eSpark-Backup/junaidalam-audioswitch/Design-Files/Audio-Switch-v2.0/Deliverables/Renderings/2D_C_View.PNG

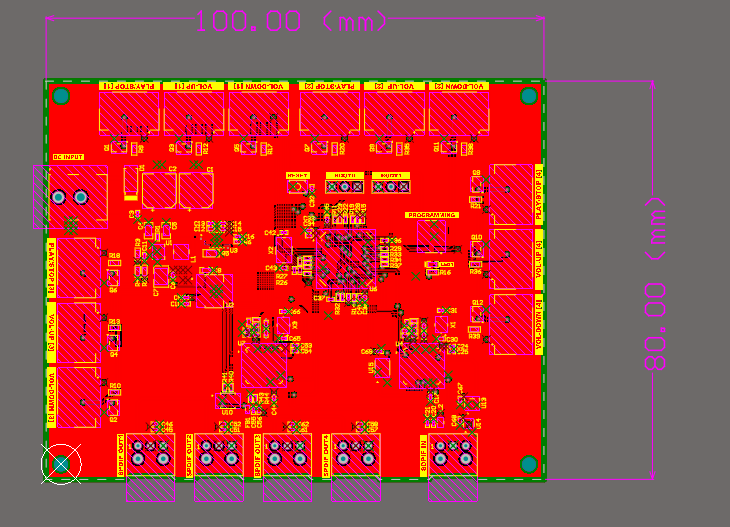
Design-Files/Audio-Switch-v2.0/Deliverables/Renderings/2D_C_View.PNG
