eSpark-Backup/junaidalam-audioswitch/Design-Files/Audio-Switch-v2.0/Deliverables/Renderings/Isometric_View.PNG

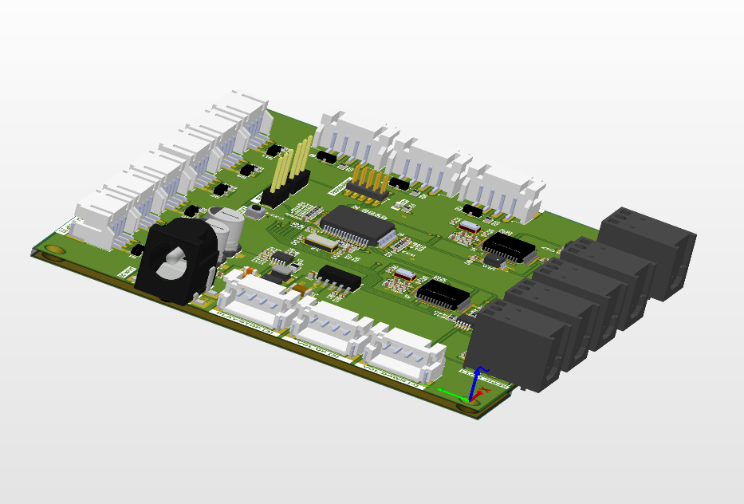
Design-Files/Audio-Switch-v2.0/Deliverables/Renderings/Isometric_View.PNG
