eSpark-Backup/junaidalam-audioswitch/Design-Files/Audio-Switch-v2.0/Deliverables/BOM/BOM of Audio-Switch-v1.0.xlsx

# | Item Type | Designator | Description | Manufacturer Part Number | Manufacturer | Comment | Quantity
1 | Capacitor | C1, C2 | CAP ALUM POLY 47UF 20% 25V SMD | 25SVPF47M | Panasonic | 47uF | 2
2 | Capacitor | C3, C11, C17, C19, C21, C23, C25, C27, C32, C34, C35, C36, C37, C38, C40, C44, C45, C48, C50, C51, C54, C55, C57, C60, C61, C67, C68, C69 | CAP CER 0.1UF 25V X7R 0402 | CC0402KRX7R8BB104 | Yageo | 0.1uF | 28
3 | Capacitor | C4, C5 | CAP CER 22UF 25V X5R 0805 | CL21A226MAYNNNE | Samsung | 22uF | 2
4 | Capacitor | C6, C18, C20, C22, C24, C26, C46, C47, C49, C52, C53, C56, C58, C59, C62 | CAP CER 10UF 10V X5R 0402 | CL05A106MP5NUNC | Samsung | 10uF | 15
5 | Capacitor | C7 | CAP CER 47uF 25V 1210 | TMK325ABJ476MM-P | Taiyo Yuden | 47uF | 1
6 | Capacitor | C8 | CAP CER 2.2UF 25V X5R 0603 | CC0603KRX5R8BB225 | Yageo | 2.2uF | 1
7 | Capacitor | C9, C33, C39 | CAP CER 1UF 16V X5R 0402 | CC0402KRX5R7BB105 | Yageo | 1uF | 3
8 | Capacitor | C10 | CAP CER 10000PF 25V X7R 0402 | CC0402KRX7R8BB103 | Yageo | 10nF | 1
9 | Capacitor | C12, C13, C14, C15, C16, C41 | CAP CER 4.7UF 16V X5R 0402 | CL05A475MO5NUNC | Samsung | 4.7uF | 6
10 | Capacitor | C28, C63 | CAP CER 0.068UF 50V X7R 0402 | CC0402KRX7R9BB683 | Yageo | 68nF | 2
11 | Capacitor | C29, C64 | CAP CER 4700PF 50V X7R 0402 | CC0402KRX7R9BB472 | Yageo | 4.7nF | 2
12 | Capacitor | C30, C31, C65, C66 | CAP CER 18PF 50V C0G/NP0 0402 | GCM1555C1H180GA16D | Murata | 18pF | 4
13 | Capacitor | C42, C43 | CAP CER 30PF 50V C0G/NPO 0402 | CC0402JRNPO9BN300 | Yageo | 30pF | 2
14 | Schottky Diode | D1 | 60V 700mV@1A 1A SMA(DO-214AC) Schottky Barrier Diodes (SBD) ROHS | SS16 | MDD | SS16 | 1
15 | Ferrite Bead | FB1 | FERRITE BEAD 120 OHM 0603 1LN | BLM18SG121TN1D | Murata | BLM18SG121TN1D | 1
16 | Connectors | J1 | DC Power Receptacle Jack 2.5A 2.5mm 6.5mm SMD Power Connectors RoHS | DC-005-5A-2.5-SMT | XKB Enterprise | DC-005-5A-2.5-SMT | 1
17 | Connectors | J2, J3, J5, J6, J8, J9, J11, J12, J13, J14, J15, J16 | CONN HEADER SMD R/A 4POS 2MM | S4B-PH-SM4-TB(LF)(SN) | JST | S4B-PH-SM4-TB(LF)(SN) | 12
18 | Male Header | J4, J7 | Gold 250V 3A Straight Square Pins 2.5mm 3P 260℃ 6mm -40℃~+105℃ 3mm 2.54mm Plugin Black Brass 1x3P Plugin,P=2.54mm Pin Headers ROHS | X6511WV-03H-C60D30 | XKB | X6511WV-03H-C60D30 | 2
19 | Jtag Male Header | J10 | CONN HEADER SMD 10POS 1.27MM | 20021121-00010C4LF | Amphenol FCI | 20021121-00010C4LF | 1
20 | Inductor | L1 | 2.34A 1.5uH Shielded Power Inductors ±20% SMD Power Inductors ROHS | LVT303012-1R5M-N | Chilisin Elec | 1.5uH | 1
21 | Inductor | L2 | 280mA 47uH ±20% 3.4Ω 0805 Inductors (SMD) ROHS | MLW2012RF-470MT | MetalLions | 47uH | 1
22 | LED | LED1 | RED LED 0603 Light Emitting Diodes | NCD0603R3 | Foshan NationStar Optoelectronics | RED | 1
23 | BJTs | Q1, Q2, Q3, Q4, Q5, Q6, Q7, Q8, Q9, Q10, Q11, Q12 | TRANS PREBIAS NPN 50V SOT23-3 | DDTD113ZC-7-F | Diodes Zetex | DDTD113ZC-7-F | 12
24 | Resistor | R1, R8, R11, R14, R15, R19, R24, R25, R26, R27, R28, R29, R30, R31, R32, R33, R34, R37, R40, R41, R43 | RES 10K OHM 1% 1/16W 0402 | RC0402FR-0710KL | Yageo | 10K | 21
25 | Resistor | R2 | RES SMD 523K OHM 0.1% 1/10W 0603 | RT0603BRD07523KL | Yageo | 523K | 1
26 | Resistor | R3, R4 | RES SMD 100K OHM 0.1% 1/10W 0603 | RT0603BRD07100KL | Yageo | 100K | 2
27 | Resistor | R5 | RES SMD 649 OHM 0.1% 1/8W 0805 | RT0805BRD07649RL | Yageo | 649R | 1
28 | Resistor | R6 | RES 49.9K OHM 1% 1/16W 0402 | RC0402FR-0749K9L | Yageo | 49.9K | 1
29 | Resistor | R7, R42 | RES 680 OHM 1% 1/16W 0402 | RC0402FR-07680RL | Yageo | 680R | 2
30 | Resistor | R9, R10, R12, R13, R17, R18, R20, R21, R35, R36, R38, R39 | RES SMD 100 OHM 1% 1/10W 0603 | RC0603FR-07100RL | Yageo | 100R | 12
31 | Resistor | R16 | RES SMD 220 OHM 1% 1/10W 0603 | RC0603FR-07220RL | Yageo | 220R | 1
32 | Resistor | R22, R23 | RES 4.7K OHM 1% 1/16W 0402 | RC0402FR-074K7L | Yageo | 4.7K | 2
33 | Resistor | R44 | RES 33 OHM 1% 1/16W 0402 | RC0402FR-0733RL | Yageo | 33R | 1
34 | Switch | SW1 | SWITCH TACTILE SPST-NO 0.05A 12V | B3U-1000P | Omron | B3U-1000P | 1
35 | IC | U1 | IC REG BCK BST ADJ 3.6A 15VQFN | TPS63070RNMR | Texas Instruments | TPS63070RNMR | 1
36 | IC | U2 | IC REG LINEAR 3.3V 1A SOT223-6 | TPS79633DCQR | Texas Instruments | TPS79633DCQR | 1
37 | IC | U3 | IC REG LIN POS ADJ 200MA 10MSOP | LT3042IMSE#PBF | Analog Devices / Linear Technology | LT3042IMSE#PBF | 1
38 | Amplifiers - Audio | U4, U7 | IC AUDIO TRANSCEIVER 48LQFP | PCM9211PTR | Texas Instruments | PCM9211PTR | 2
39 | FIBER OPTIC RECEIVER | U5 | FIBER OPTIC RECEIVER IR | PLR237/T10BK | Everlight | PLR237/T10BK | 1
40 | Microcontrollers | U6 | IC MCU 32BIT 256KB FLASH 64LQFP | STM32F401RCT6 | STMicroelectronics | STM32F401RCT6 | 1
41 | IC | U8, U9, U11, U12 | TRANSMITTER FBR OPT IR PHOTOLINK | PLT133/T10W | Everlight | PLT133/T10W | 4
42 | IC | U10 | IC SWITCH SP4T X 1 5OHM 10VSSOP | TMUX1204DGSR | Texas Instruments | TMUX1204DGSR | 1
43 | Buffers, Drivers and Transceivers | U13 | IC BUFF NON-INVERT 5.5V SOT23-5 | SN74LVC1G125DBVR | Texas Instruments | SN74LVC1G125DBVR | 1
44 | Logic Gates | U14 | IC GATE AND 1CH 2-INP SC70-5 | SN74LVC1G08DCKR | Texas Instruments | SN74LVC1G08DCKR | 1
45 | IC | U15 | IC BUFFER NON-INVERT 5.5V SM8 | SN74LVC2G125DCTR | Texas Instruments | SN74LVC2G125DCTR | 1
46 | Crystal | X1, X3 | 24.576MHz SMD Crystal Resonator 12pF 60Ω ±10ppm -40℃~+85℃ SMD3225-4P Crystals ROHS | S3224576121060 | JGHC | S3224576121060 | 2
47 | Crystal | X2 | 8MHz 18pF ±10ppm SMD5032-4P Crystals ROHS | 5TJ480000XYLBC | JYJE | 8MHz | 1
