eSpark-Backup/junaidalam-audioswitch/Design-Files/Audio-Switch-v2.0/Deliverables/Supporting_Files/Audio-Switch-v1.0.step

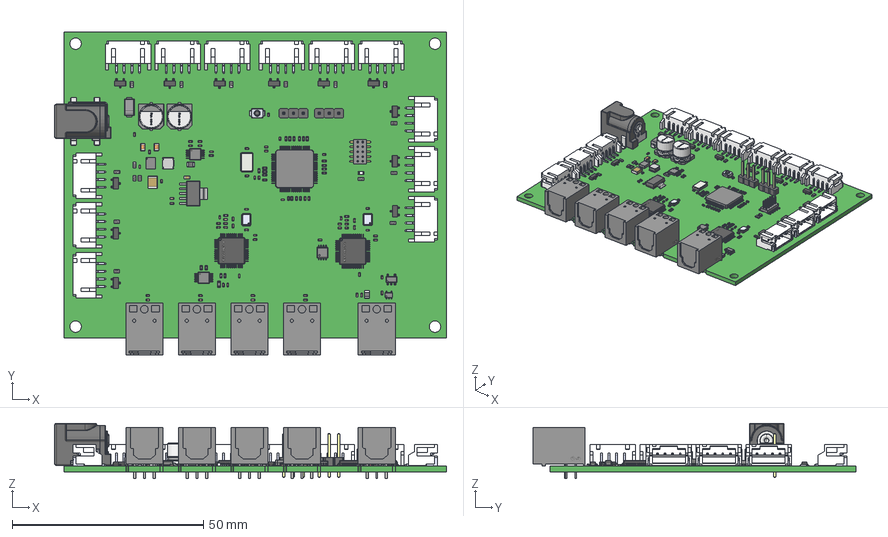
[picture p9: CAD file, 2024-05-20]
Design-Files/Audio-Switch-v2.0/Deliverables/Supporting_Files/Audio-Switch-v1.0.step
102.5 x 84.4 x 14.5 mm
SN74LVC2G125DCTR
SN74LVC1G08DCKR
SN74LV1T34DBVR
User Library-P-LQFP48-7x7-0_50 x 2
STM32F103RCT7
CircuitWorks-SOT-23 x 12
MetalFrame x 2
Pin1Marker x 2
Pin3 x 2
Pin1 x 2
Lid x 2
Pin4 x 2
Pin2 x 2
Ceramic x 2
User Library-CRYSTALSMD5X32
LTC2634HMSE-LMI10#PBF
User Library-SOT-223-6
TPS63070RNMR--3DModel-STEP-56544
User Library-OMRON B3U1000P
User Library-RES_1005-0402 x 27
User Library-RESC1608X05N x 16
User Library-CR2012-0805
User Library-LED SMD0603
SxB-PH-SM4-TB white_4 x 12
User Library-RM127_10pin_Header
User Library-Header_Male_3Pin_PinArray x 2
User Library-Header_Male_3Pin_BodyArray x 2
CUI-PJ-002A-SMT
Lötende x 2
base x 3
User Library-DO-214AC SMA
User Library-Capacitor 0402 x 63
User Library-CAPC1608X09
User Library-CAPC3225X10
User Library-0805 SMD Capacitor x 2
cap x 2
pins x 2
logo x 2
