eSpark-Backup/junaidalam-audioswitch/(list of files, cad)

Other CAD files:
Design-Files/Audio-Switch-v2.0/Deliverables/Supporting_Files/Audio-Switch-v1.0.DWG
Design-Files/Audio-Switch-v2.0/Deliverables/Supporting_Files/Audio-Switch-v1.0.DXF
