eSpark-Backup/junaidalam-audioswitch/Design-Files/Audio-Switch-v2.0/Schematic/Audio-Switch-v2.0.pdf

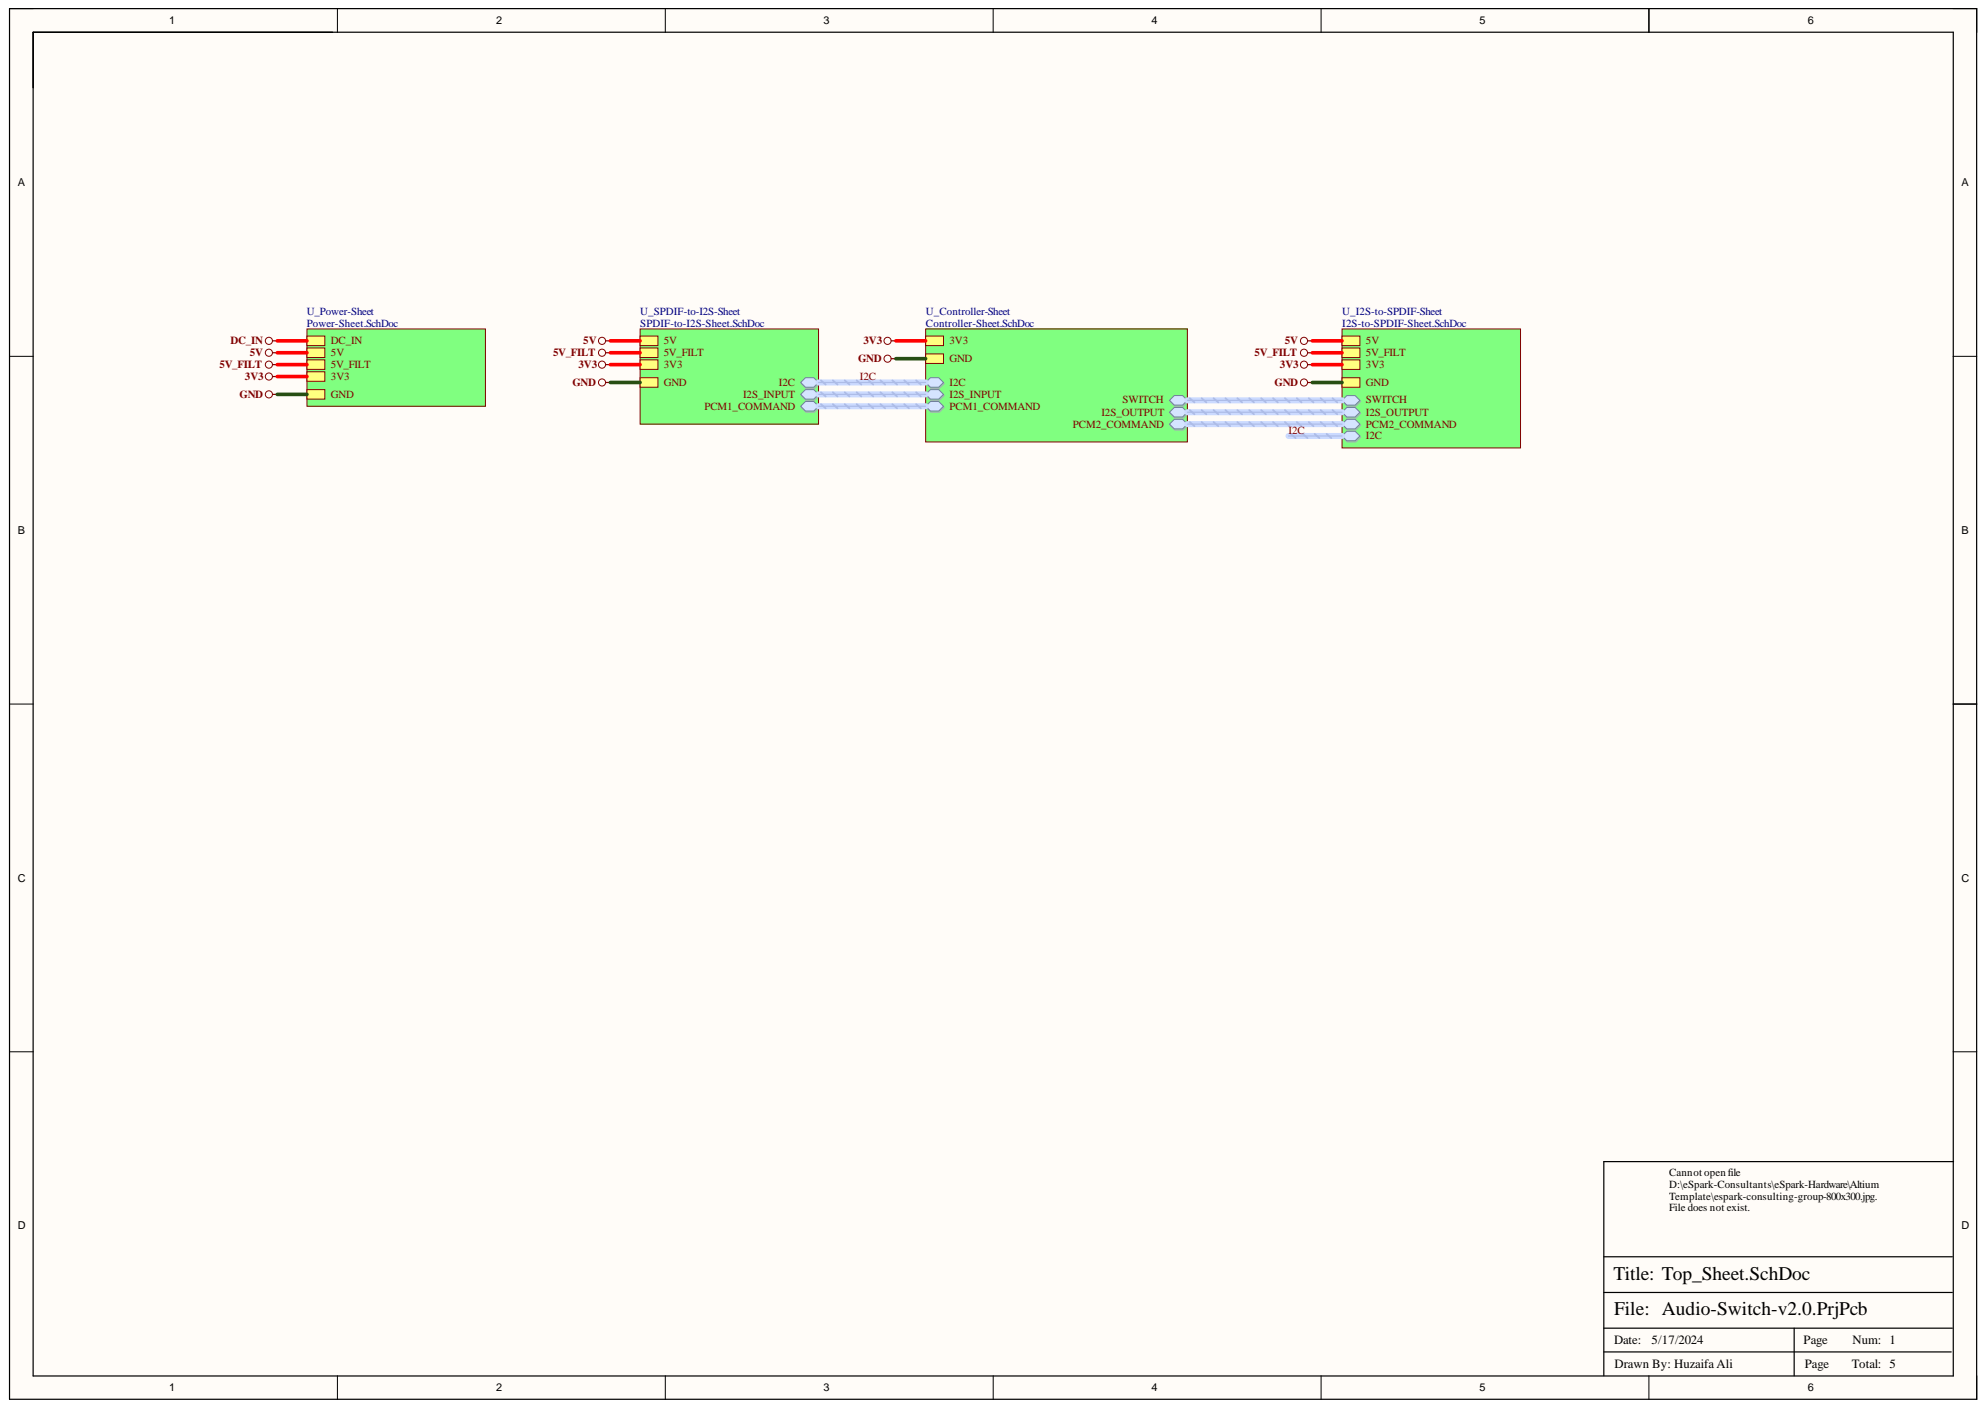
[picture p10: page 1]

Cannot open file
D:\eSpark-Consultants\eSpark-Hardware\Altium
Template\espark-consulting-group-800x300.jpg.
File does not exist.

Date: 5/17/2024 | Page Num: 1

Drawn By: Huzaifa Ali | Page Total:

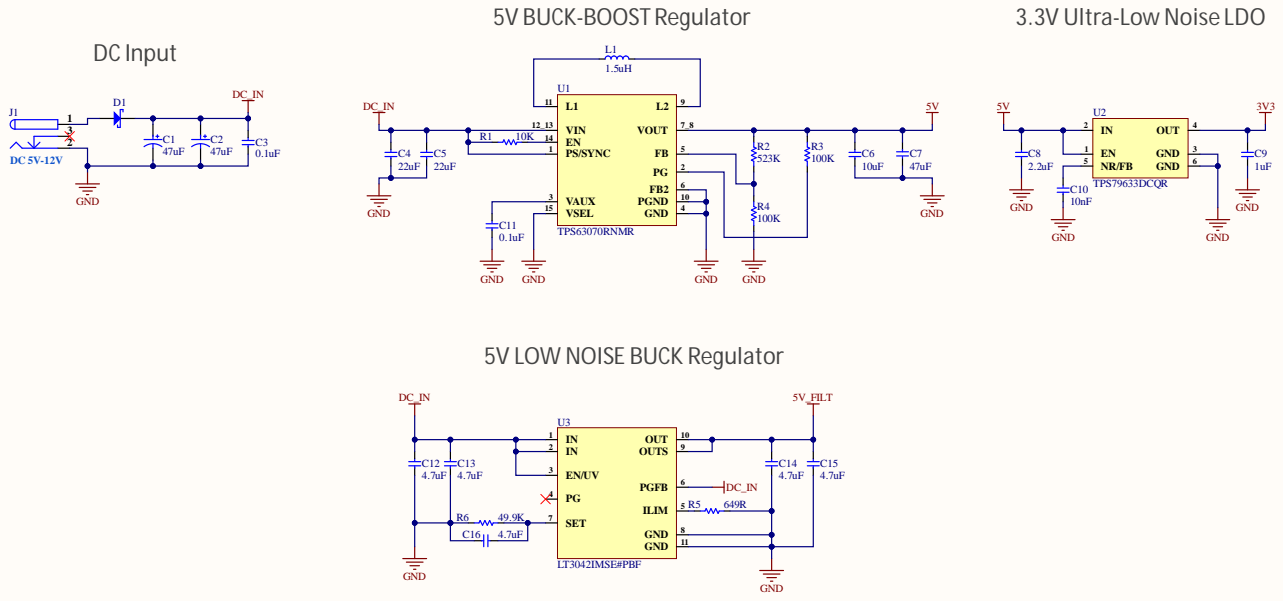
[picture p11: page 2]

5V LOW NOISE BUCK Regulator

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

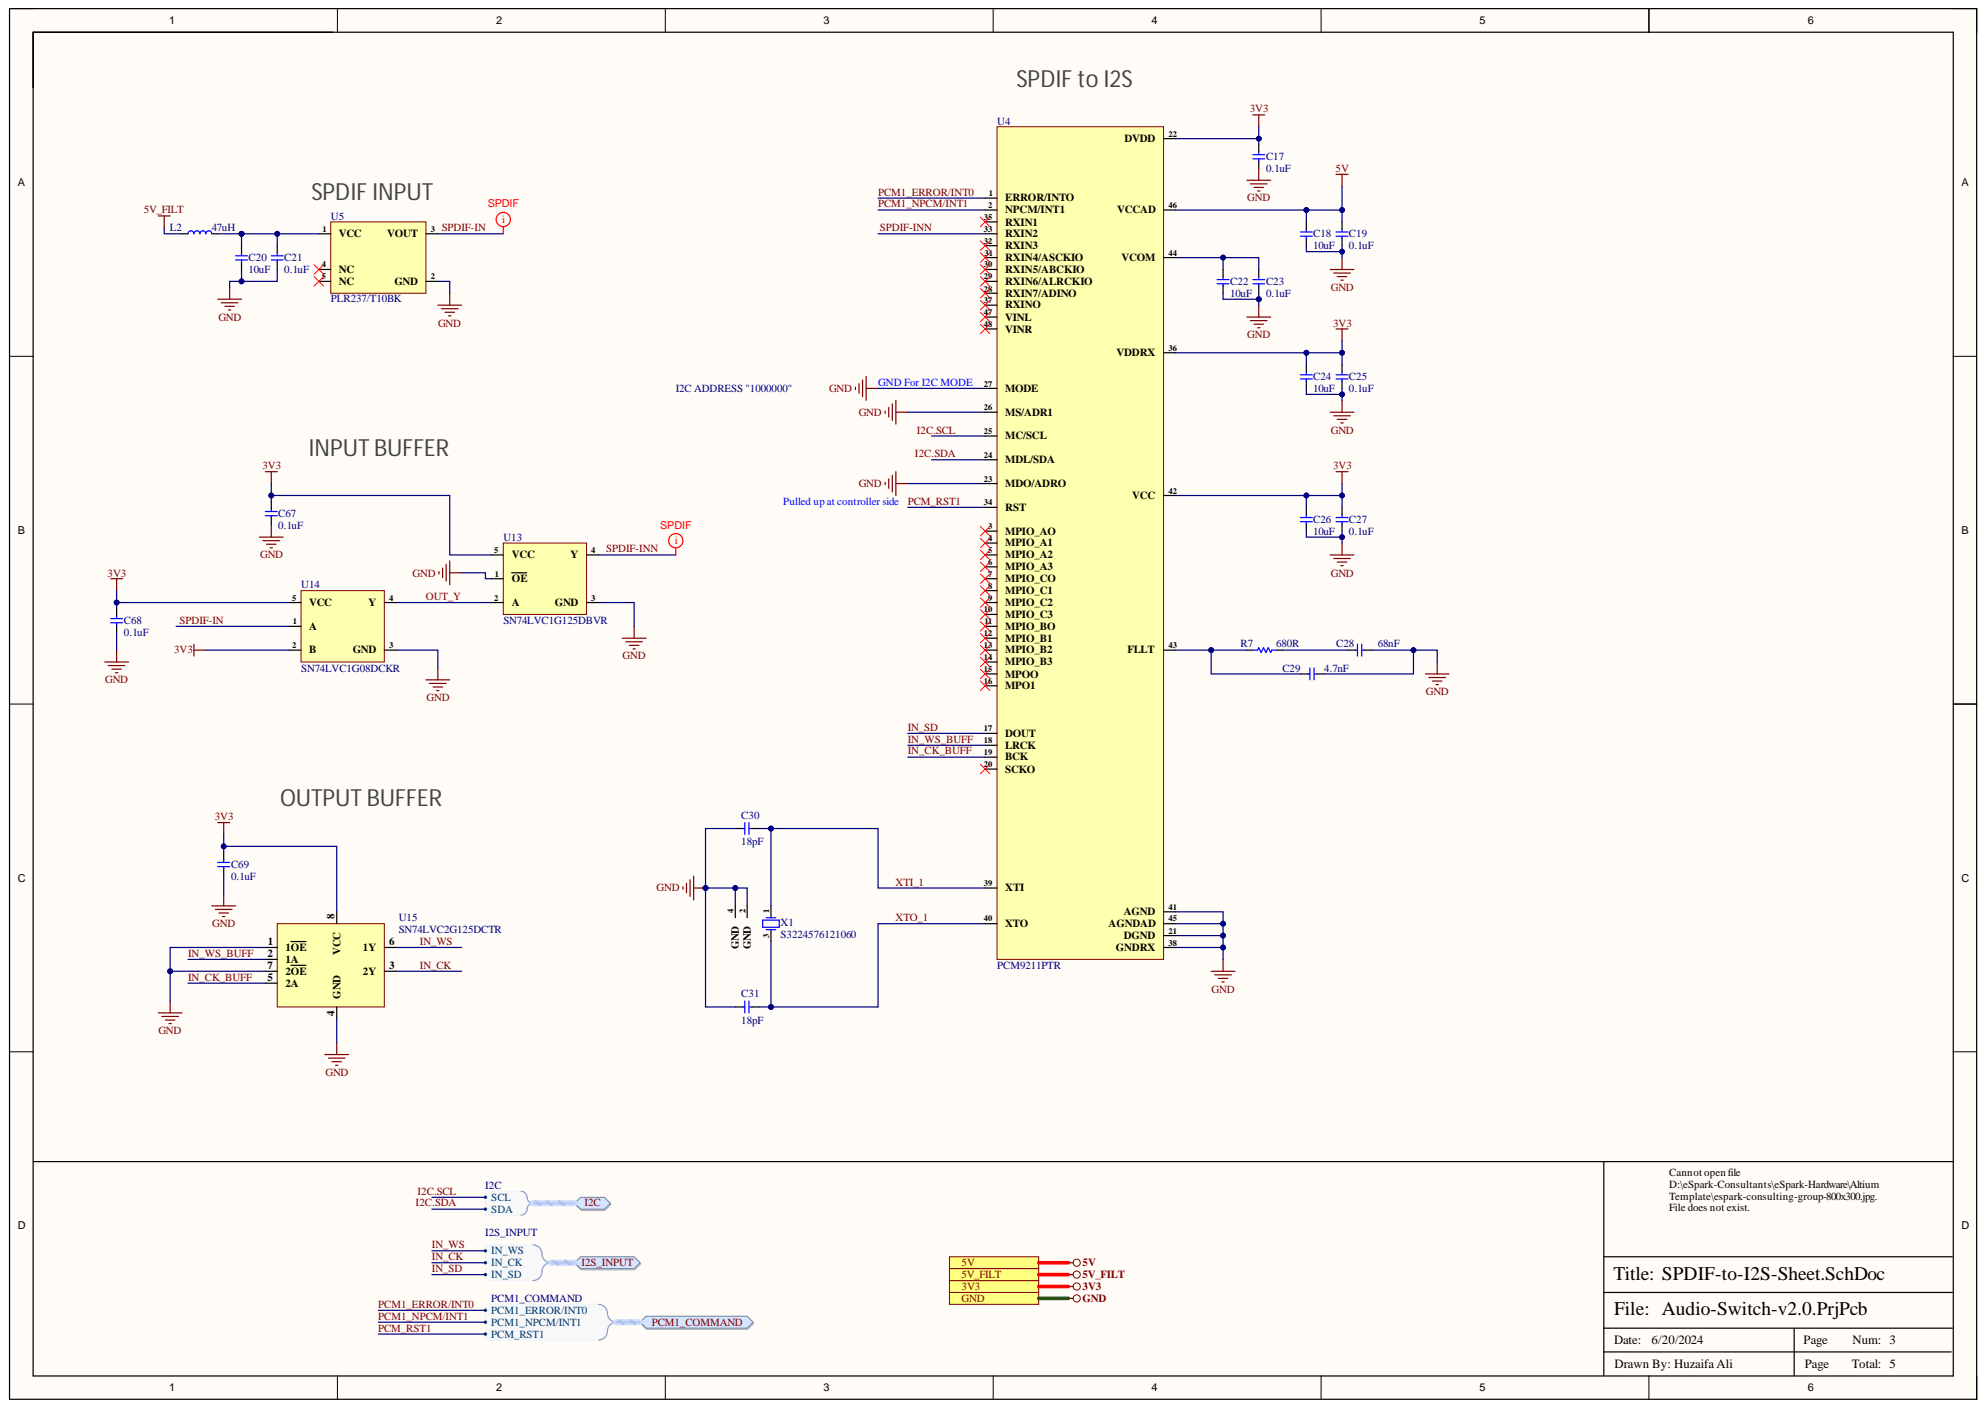
[picture p12: page 3]

Pulled up at controller side PCM_RST1

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

SPDIF-to-I2S-Sheet.SchDoc

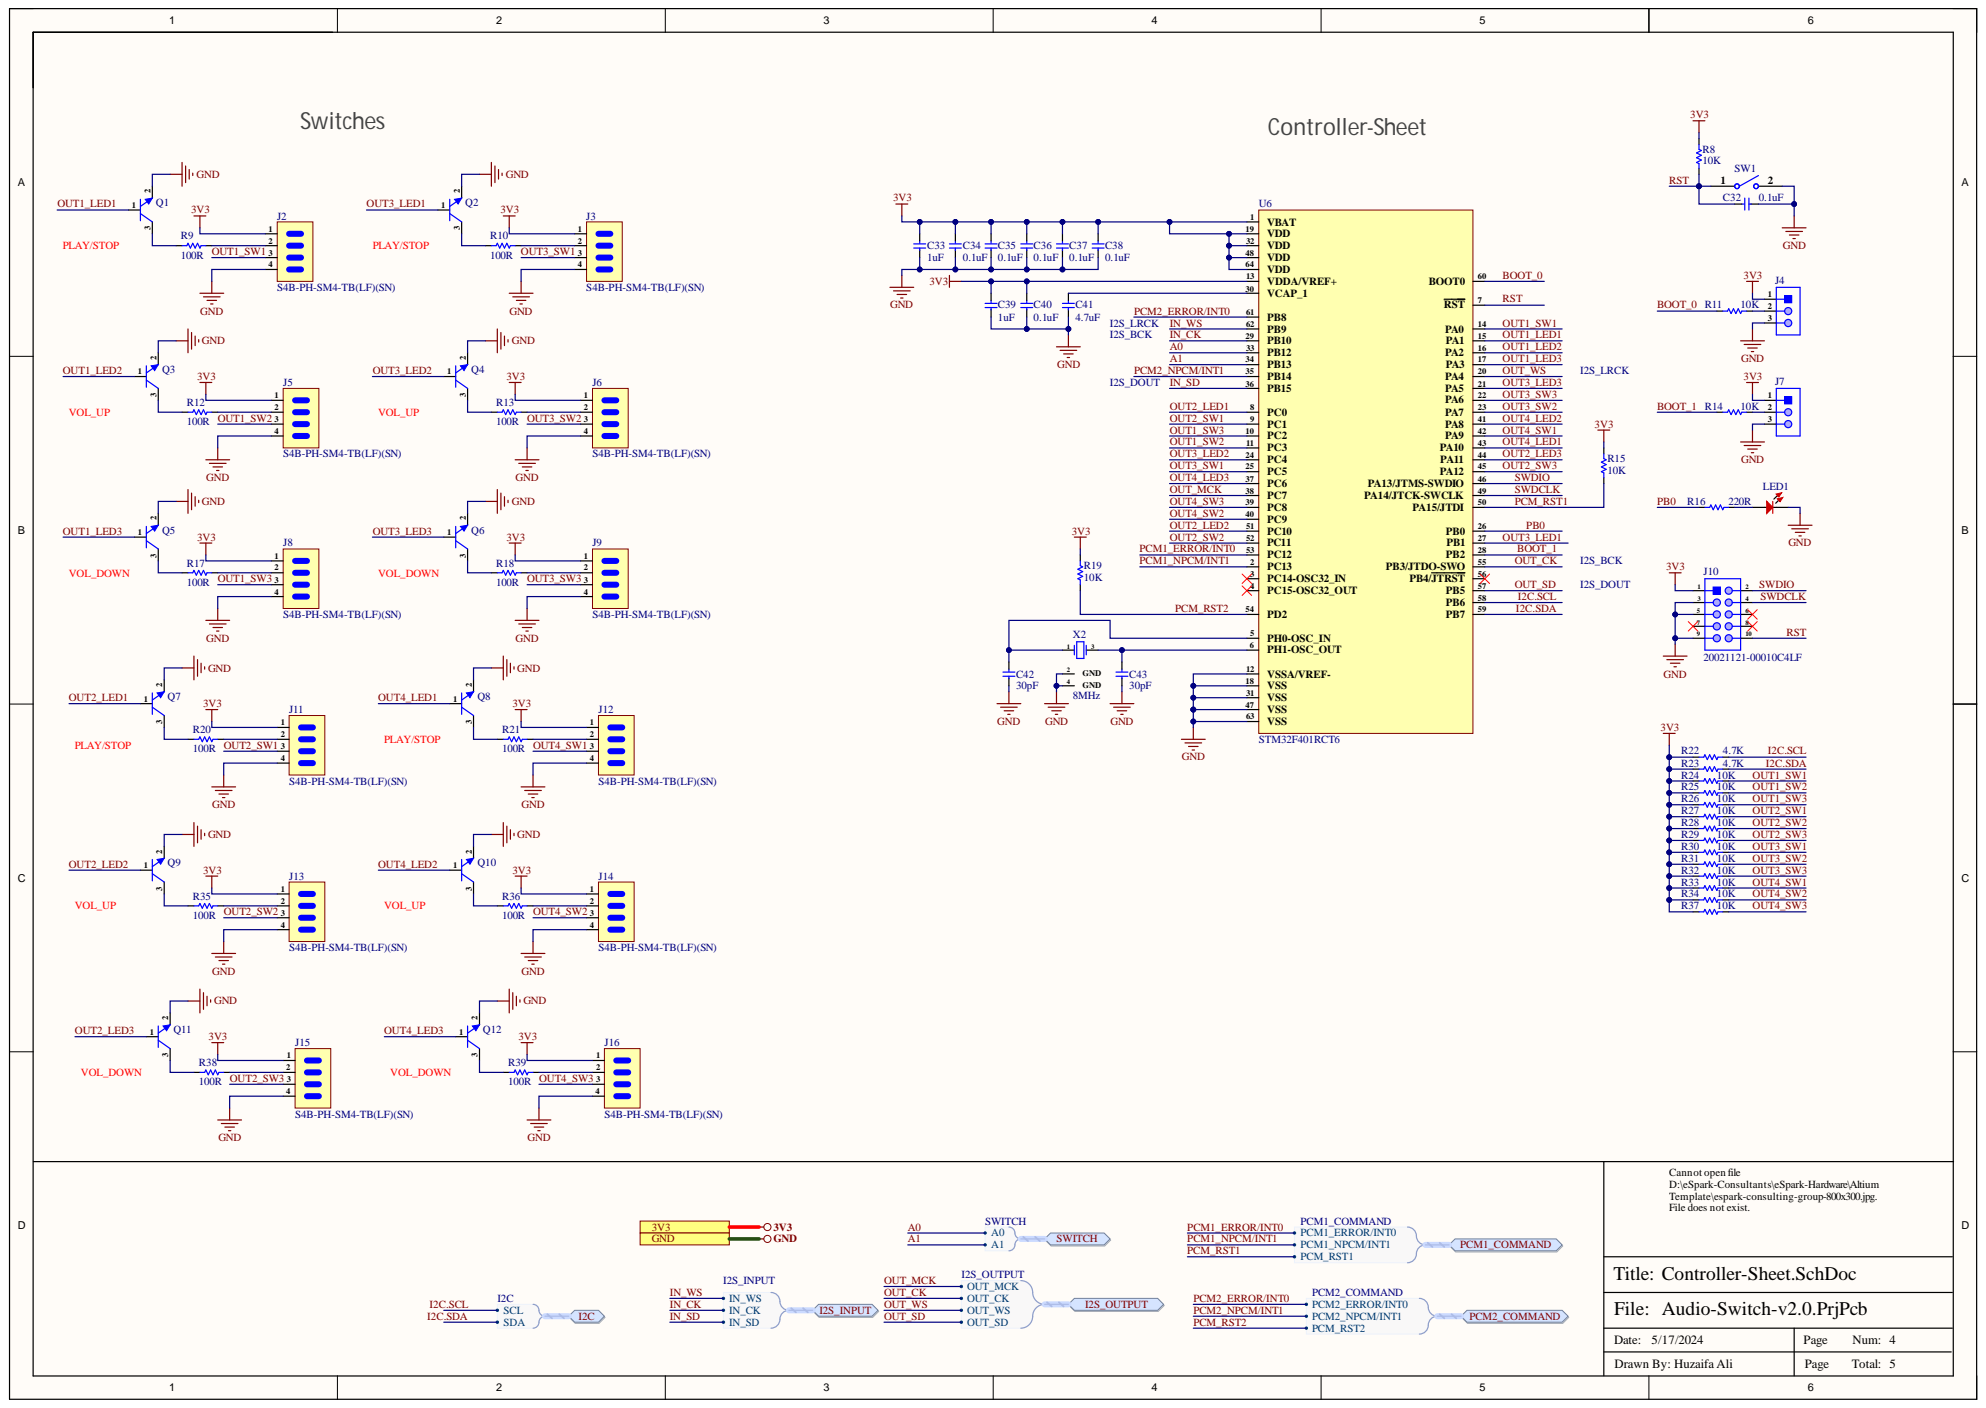
[picture p13: page 4]
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

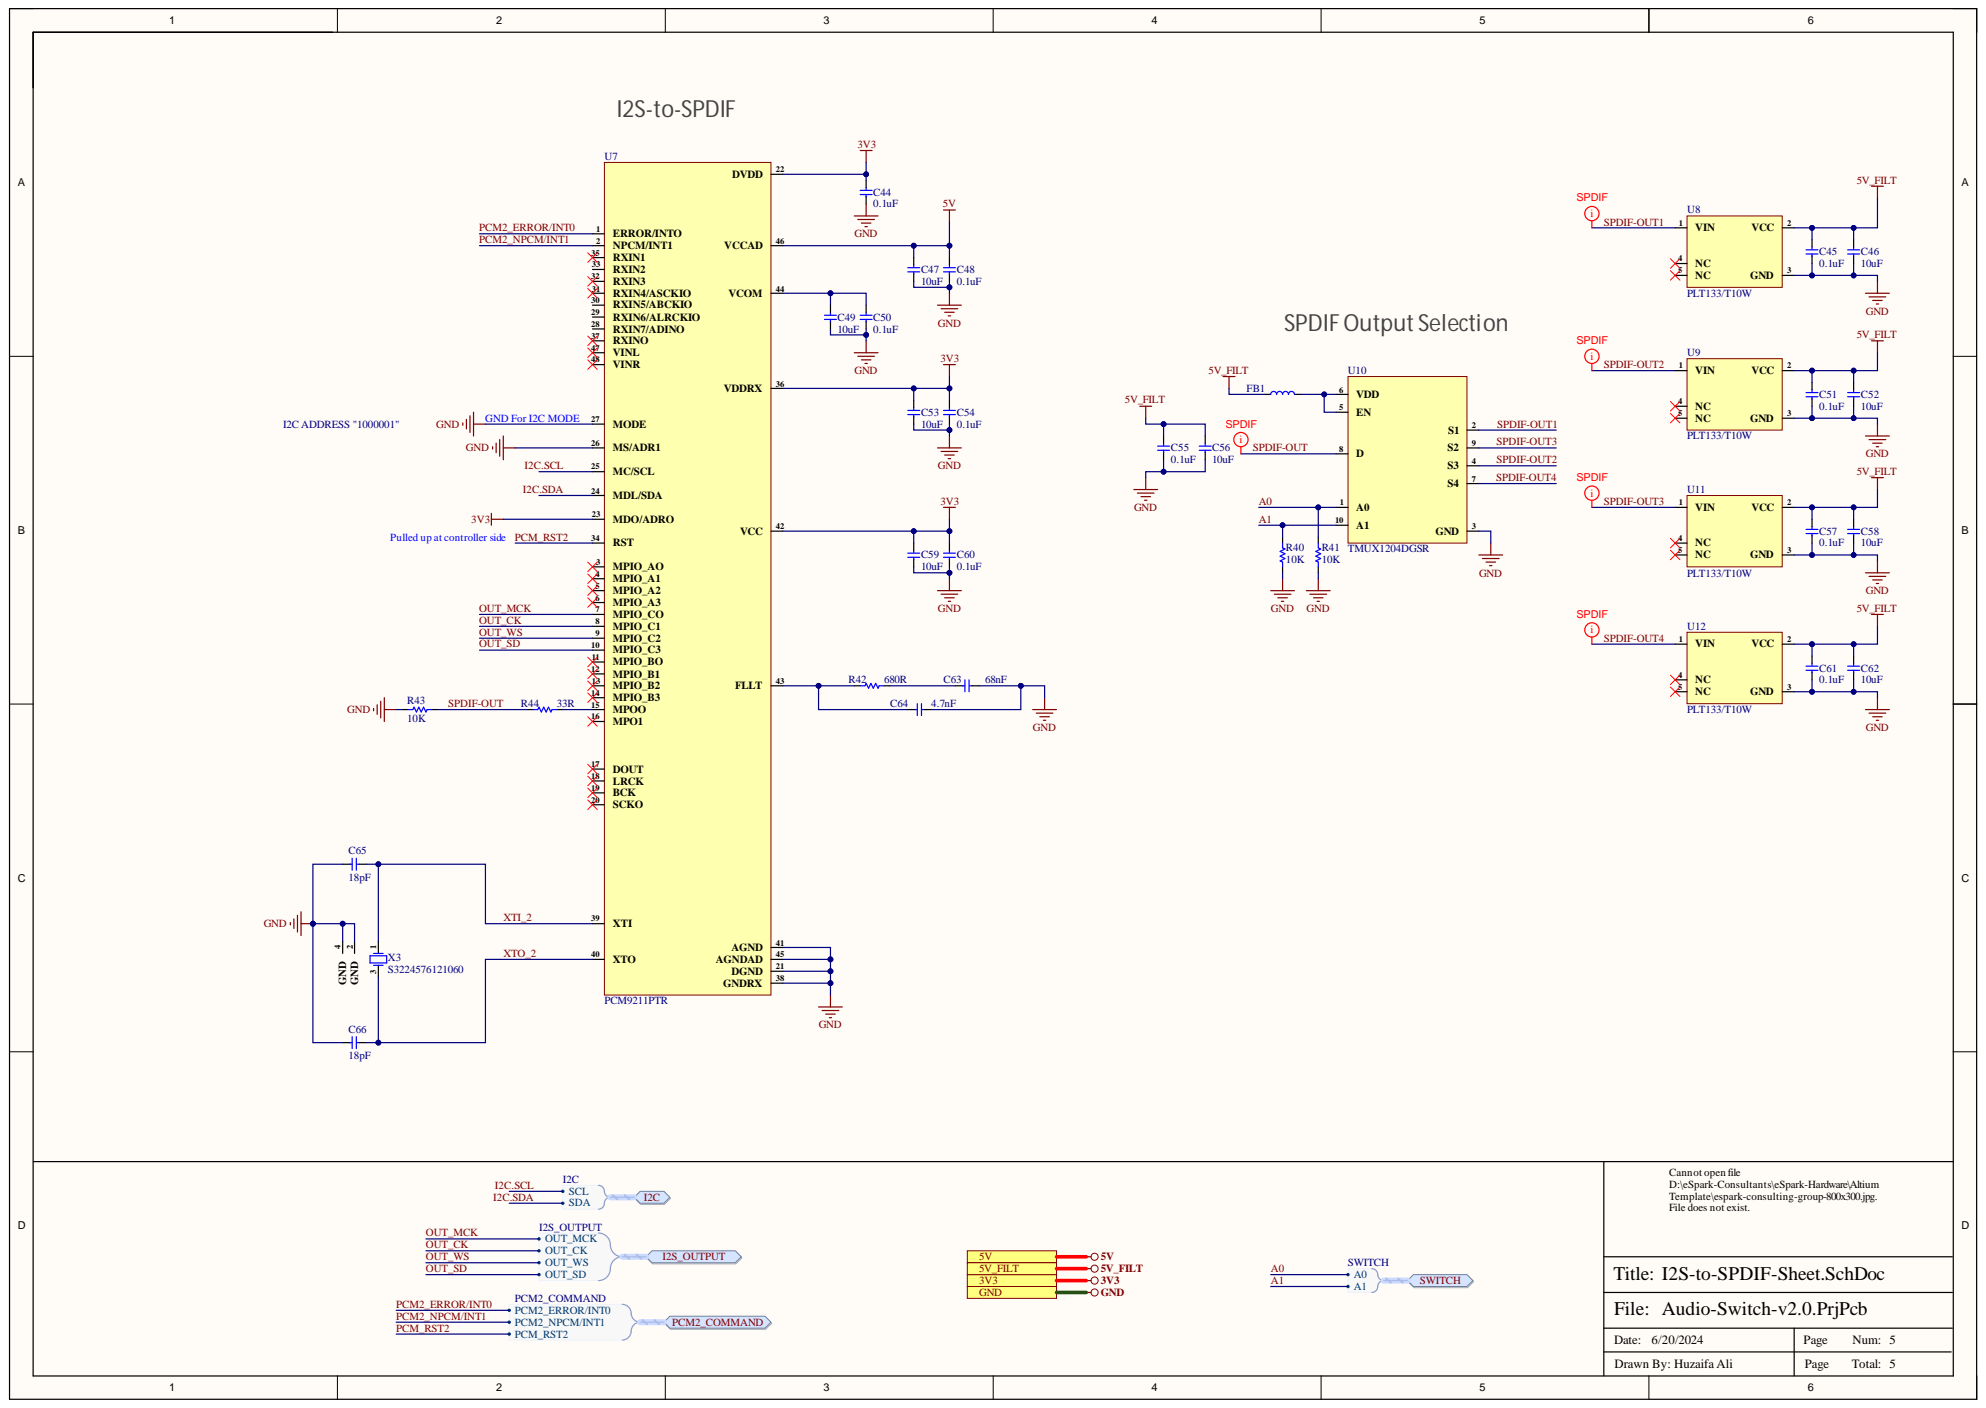
[picture p14: page 5]

Pulled up at controller side PCM_RST2

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

I2S-to-SPDIF-Sheet.SchDoc
