eSpark-Backup/junaidalam-audioswitch/Design-Files/Audio-Switch-v2.0/Deliverables/Schematic/Audio-Switch-v1.0.pdf

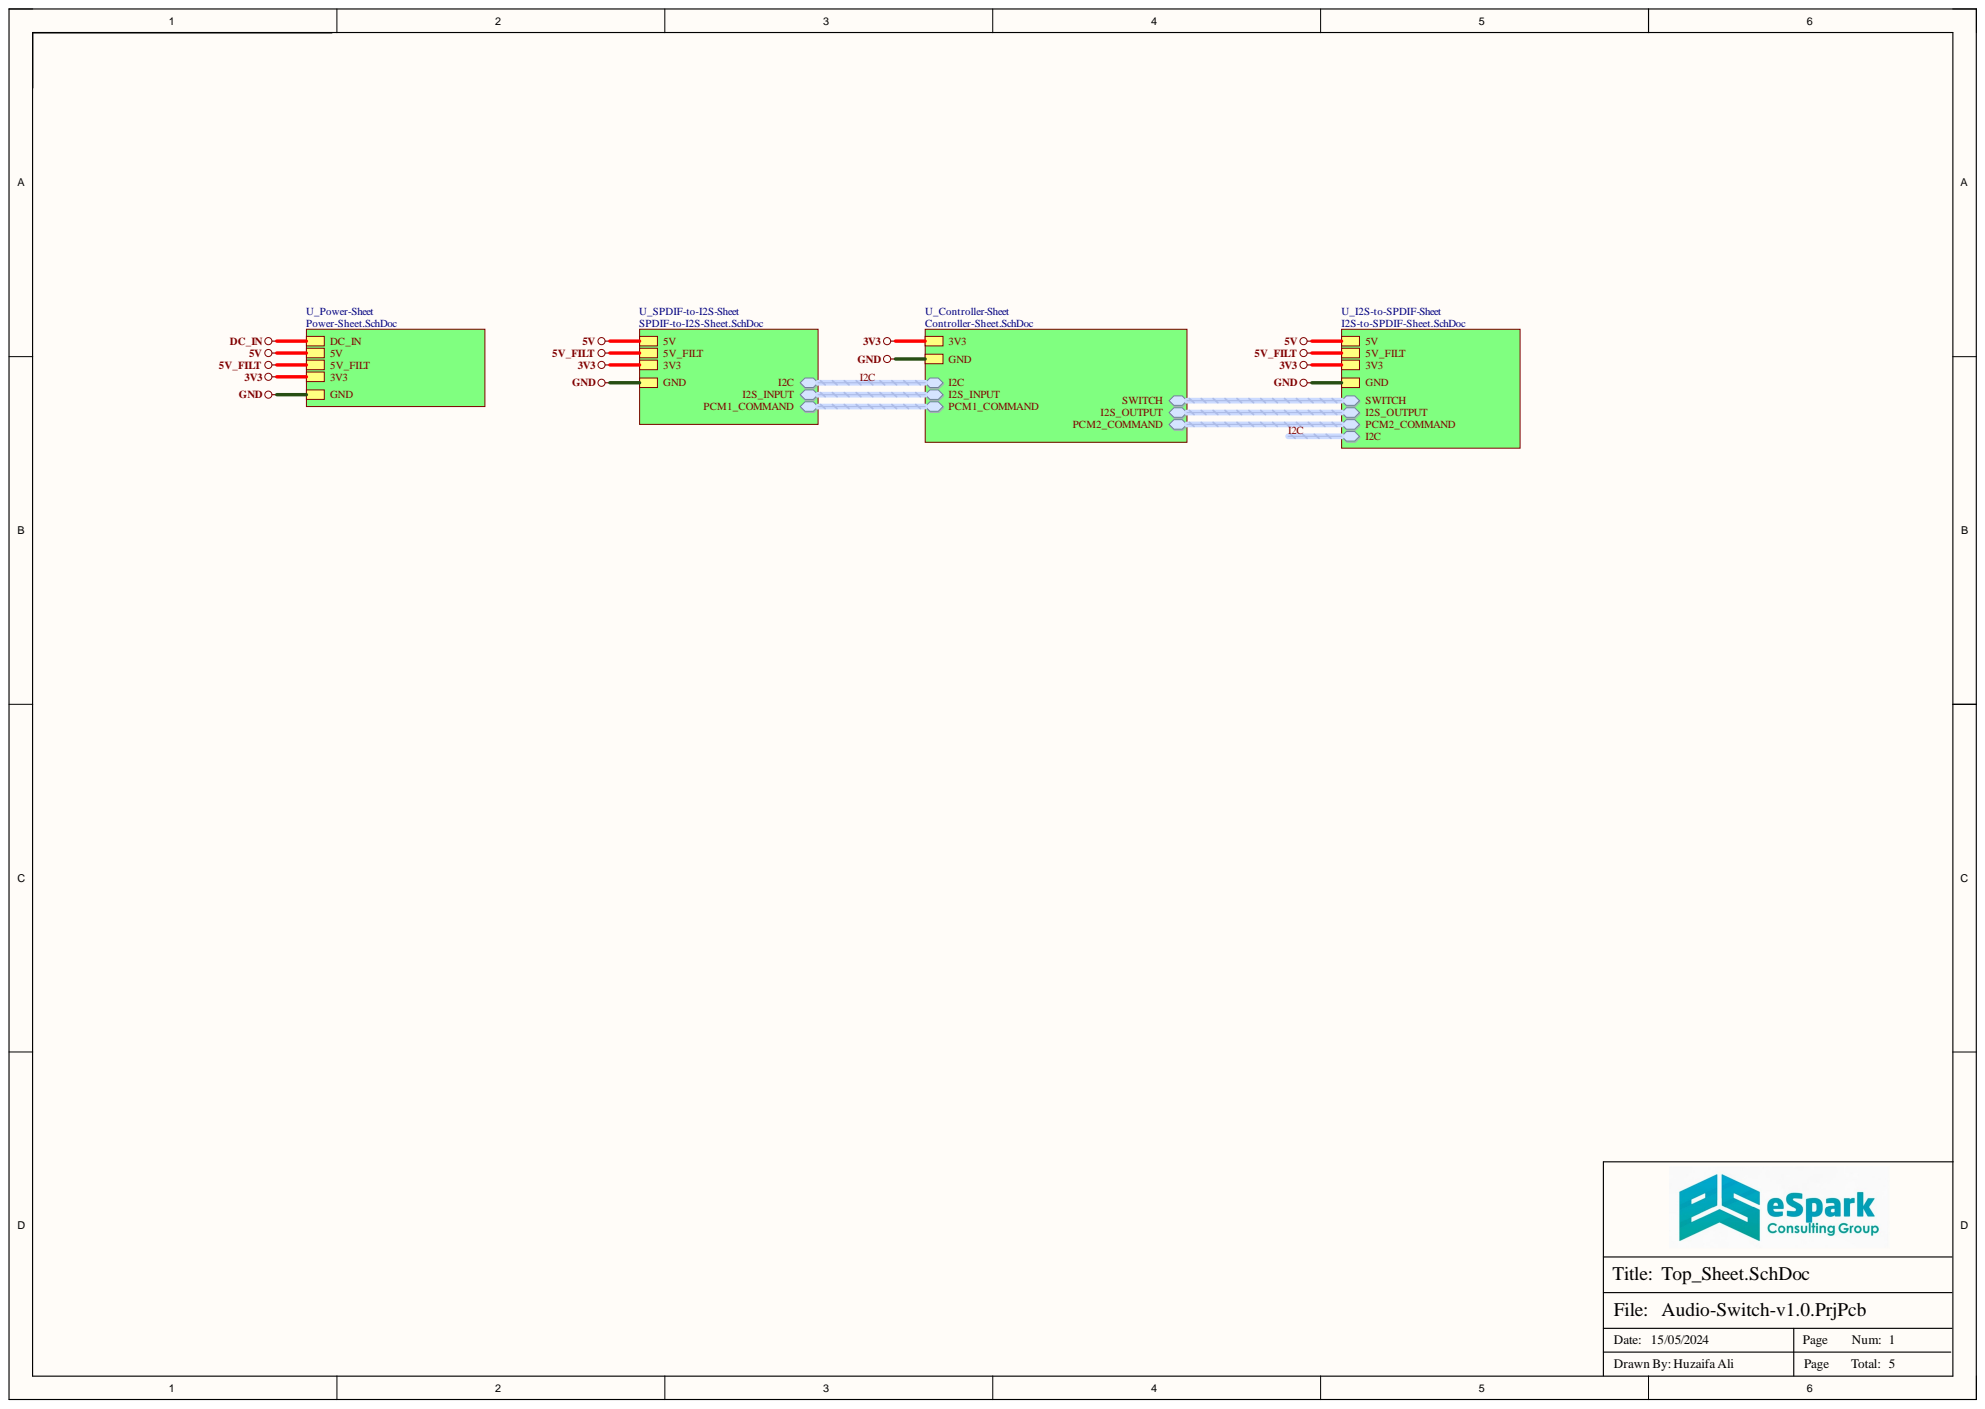
[picture p15: page 1]

Date: 15/05/2024 | Page Num: 1

Drawn By: Huzaifa Ali | Total:

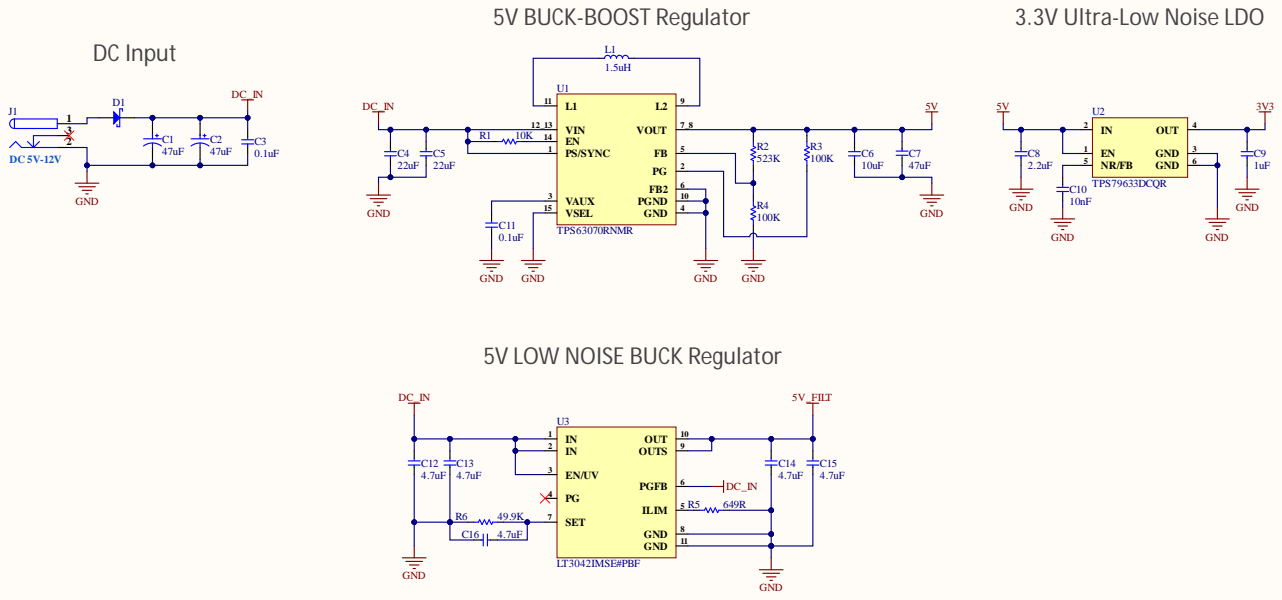
[picture p16: page 2]

5V LOW NOISE BUCK Regulator

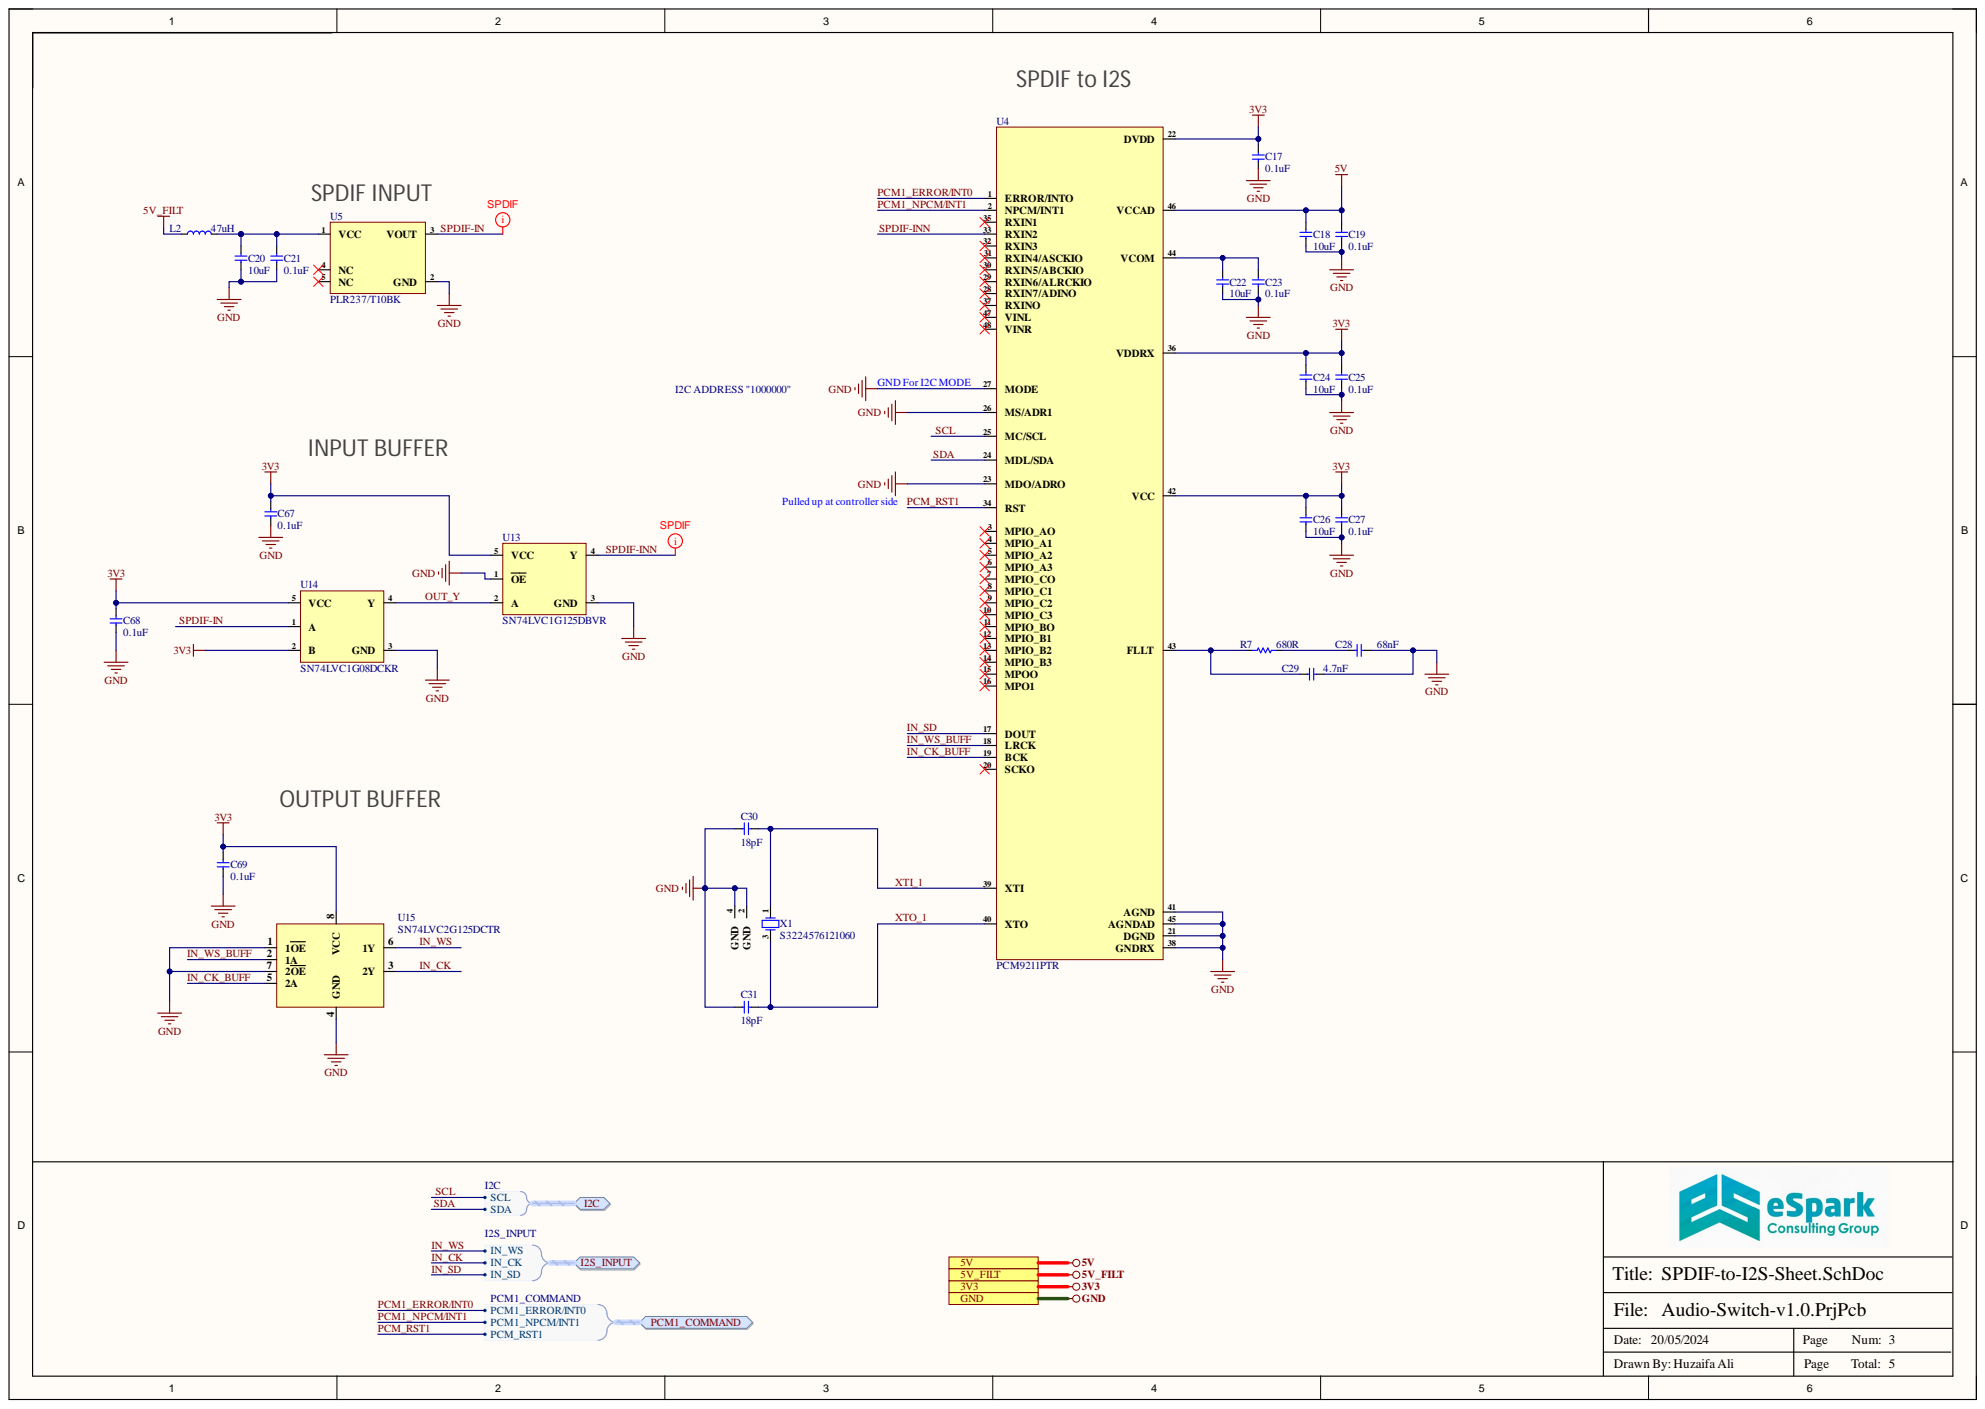
[picture p17: page 3]

Pulled up at controllerside PCM_RST1

SPDIF-to-I2S-Sheet.SchDoc

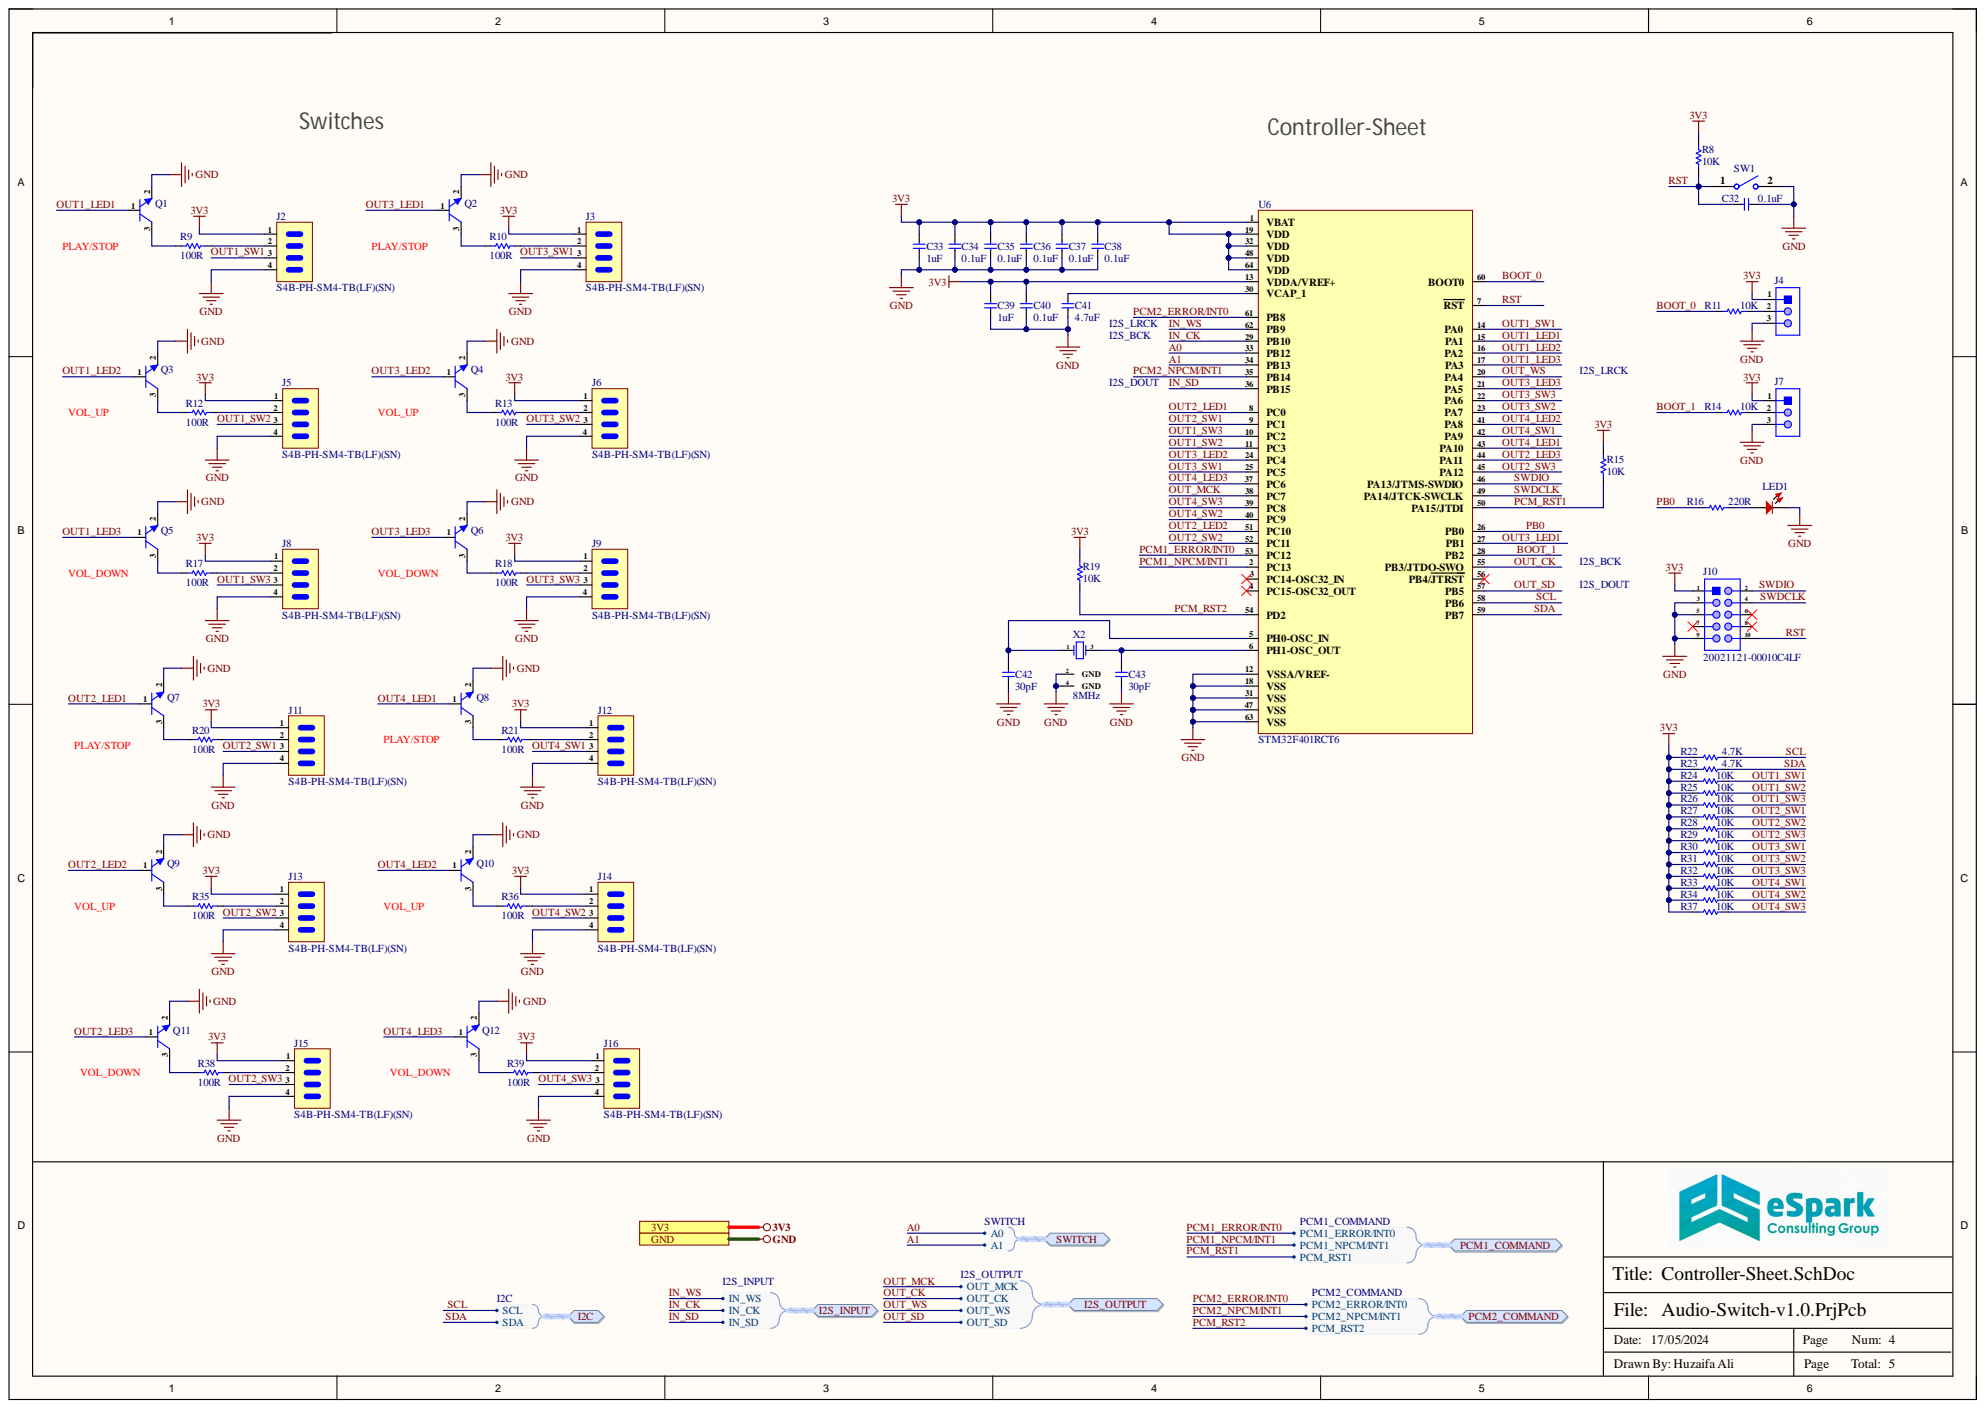
[picture p18: page 4]

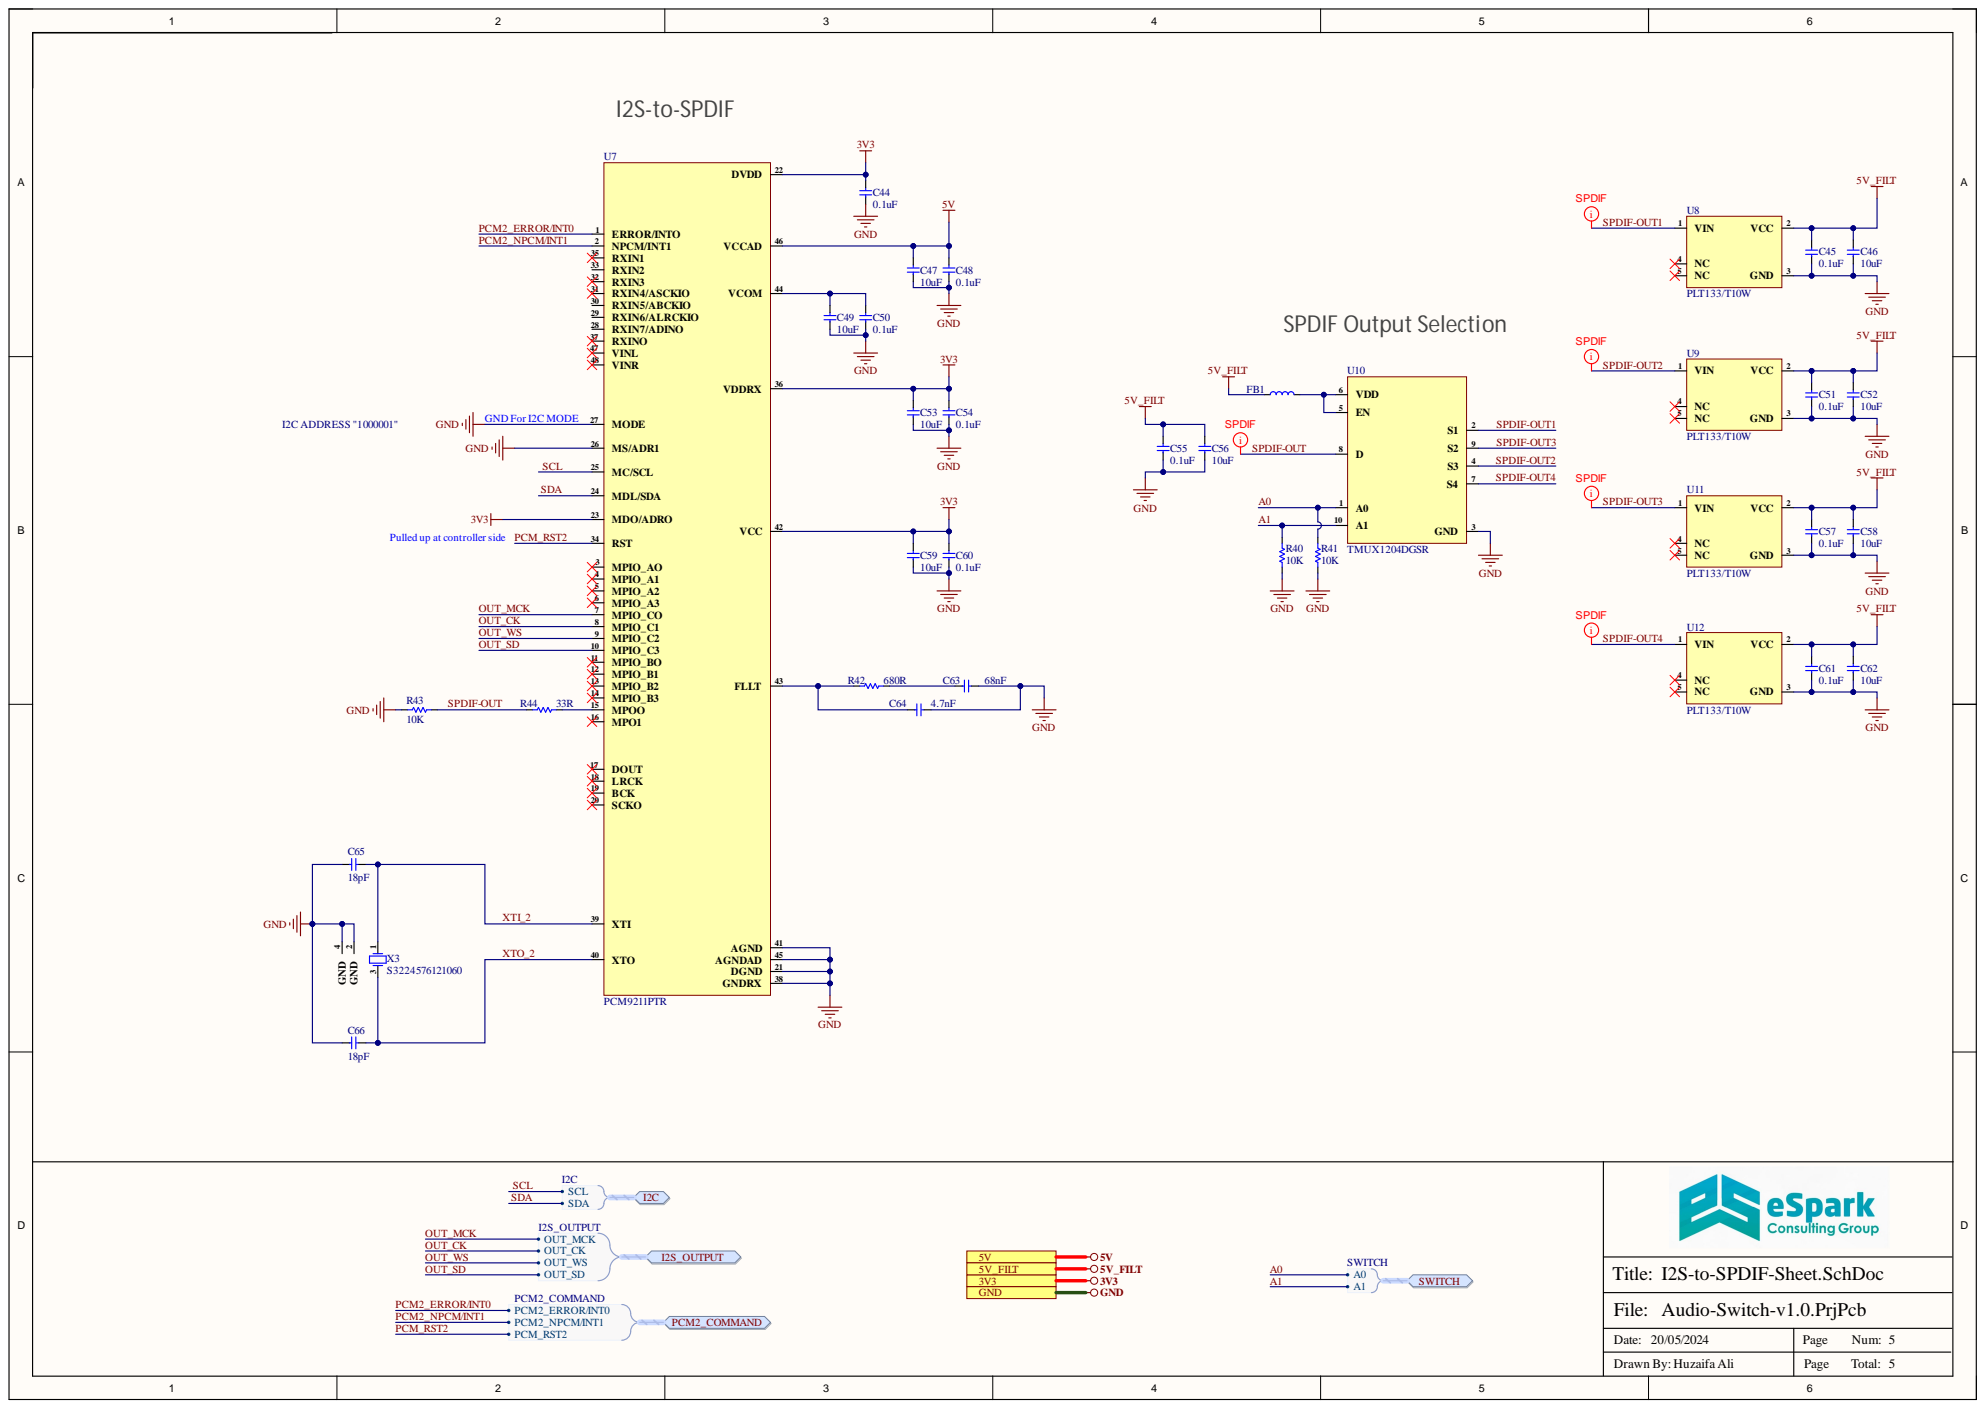
[picture p19: page 5]

Pulled up at controllerside PCM_RST2

I2S-to-SPDIF-Sheet.SchDoc

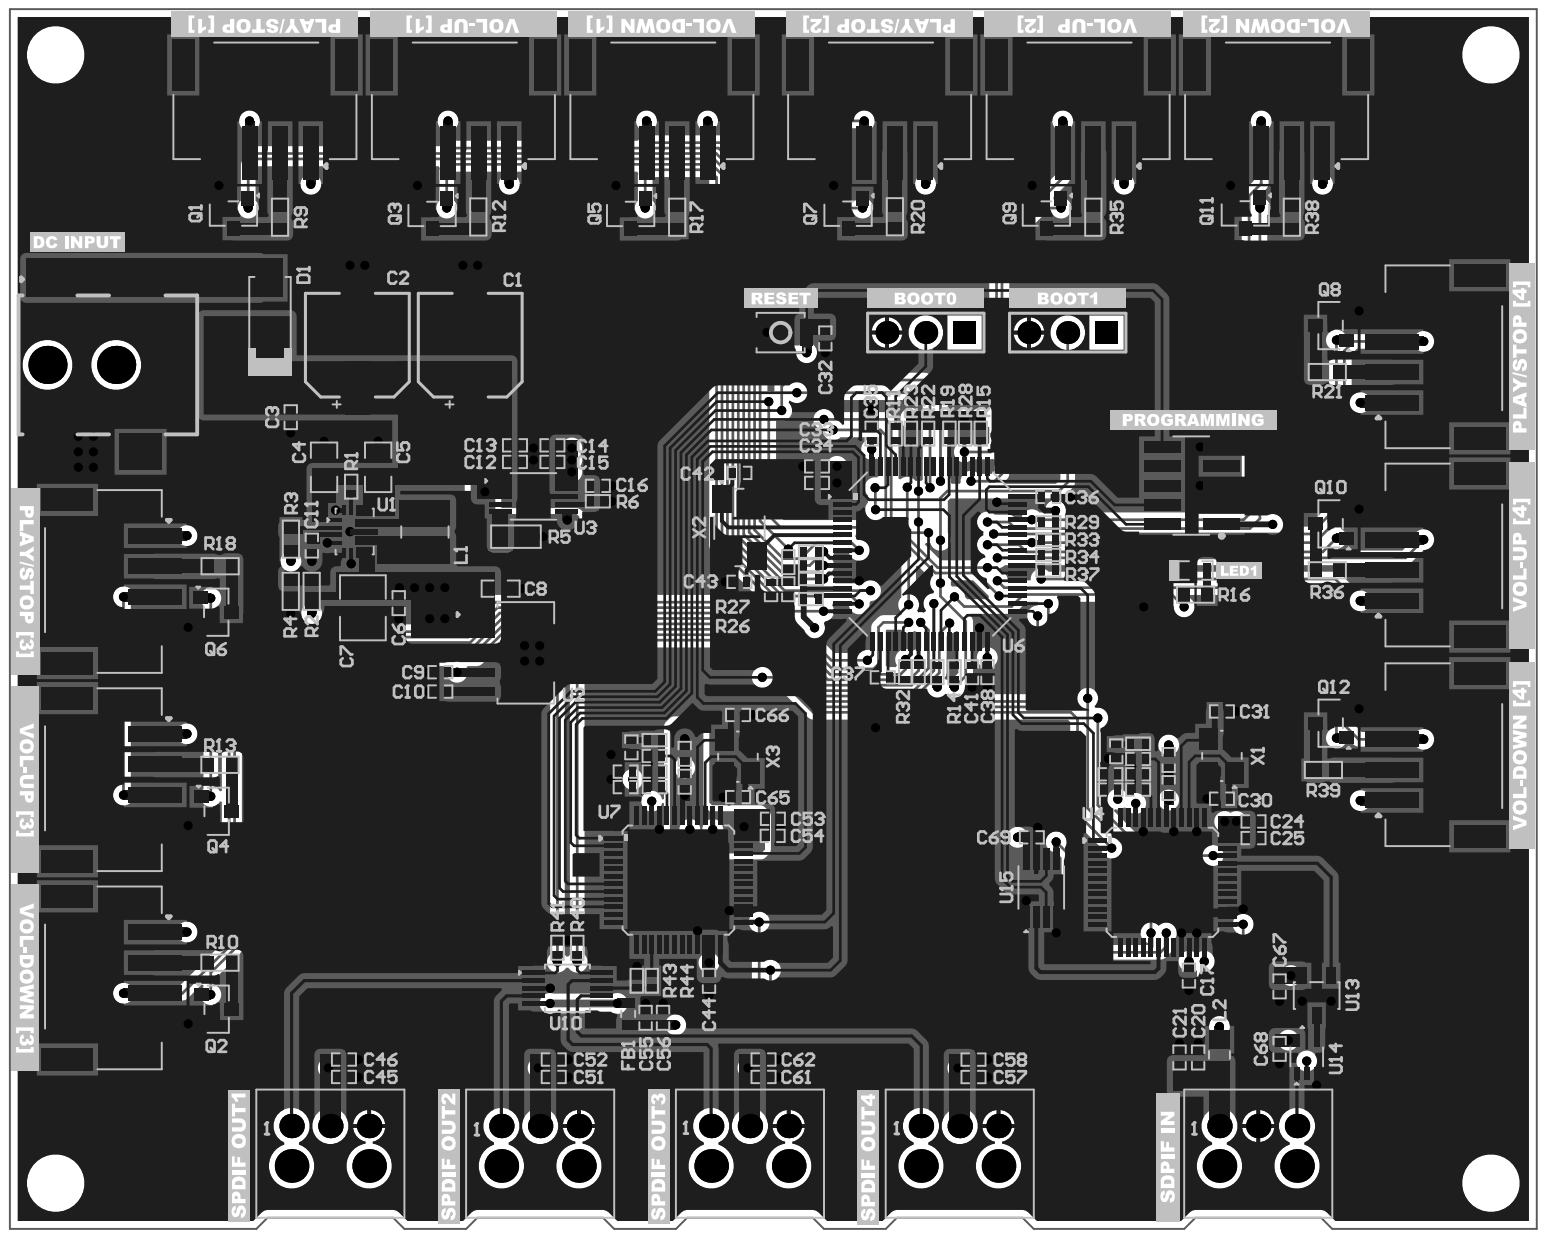
[picture p20: page 6]
