eSpark-Backup/junaidalam-audioswitch/Design-Files/Audio-Switch-v2.0/Deliverables/Schematic/Assembly_Drawing.pdf

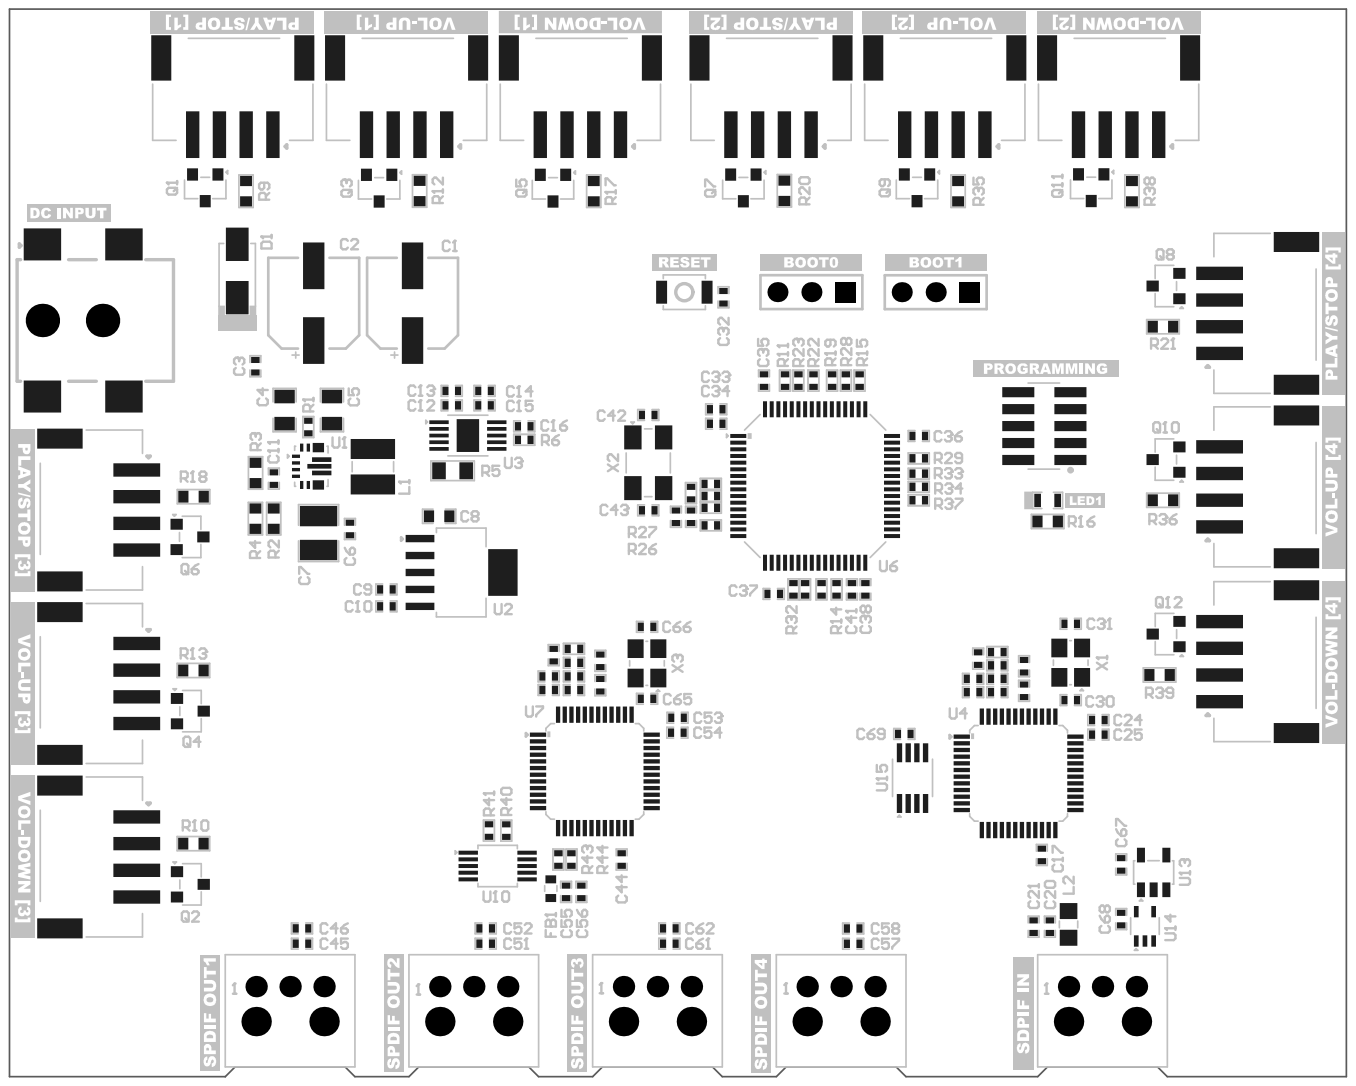
[picture p21: page 1]
