eSpark-Backup/junaidalam-audioswitch/(list of files, drawings)

Other design files:
Design-Files/Audio-Switch-v2.0/Audio-Switch-v2.0.PcbDoc
Design-Files/Audio-Switch-v2.0/Audio-Switch-v2.0.PrjPcb
Design-Files/Audio-Switch-v2.0/Controller-Sheet.SchDoc
Design-Files/Audio-Switch-v2.0/I2S-to-SPDIF-Sheet.SchDoc
Design-Files/Audio-Switch-v2.0/Power-Sheet.SchDoc
Design-Files/Audio-Switch-v2.0/SPDIF-to-I2S-Sheet.SchDoc
Design-Files/Audio-Switch-v2.0/Top_Sheet.SchDoc
