eSpark-Backup/junaidalam-audioswitch/(commit log)

2024-05-08 #1 Complete Top sheet and stuff remaining. PDF generated
    [Analog-to-I2S-Sheet.SchDoc, Audio-Switch-v1.0.PrjPcb, Controller-Sheet.SchDoc, I2S-to-SPDIF-Sheet.SchDoc, Power-Sheet.SchDoc, SPDIF-to-Analog-Sheet.SchDoc, Selector-Sheet.SchDoc]
2024-05-09 #1 3.3V LDO enable pin connected. Jlink connector added.
    [Controller-Sheet.SchDoc, Power-Sheet.SchDoc]
2024-05-13 Push button info updated in PRD v2.0
2024-05-13 #2 Schematic in progress
    [Audio-Switch-v1.0.PrjPcb, Controller-Sheet.SchDoc, I2S-to-SPDIF-Sheet.SchDoc, SPDIF-to-Analog-Sheet.SchDoc, Selector-Sheet.SchDoc]
2024-05-14 #2 Schematic completed except Top Sheet
    [Analog-to-I2S-Sheet.SchDoc, Audio-Switch-v1.0.PrjPcb, Controller-Sheet.SchDoc, I2S-to-SPDIF-Sheet.SchDoc, Power-Sheet.SchDoc, SPDIF-to-Analog-Sheet.SchDoc]
2024-05-14 #2 Schematic completed and PDF generated
    [Audio-Switch-v1.0.PrjPcb, Controller-Sheet.SchDoc, I2S-to-SPDIF-Sheet.SchDoc, Power-Sheet.SchDoc, SPDIF-to-Analog-Sheet.SchDoc, SPDIF-to-I2S-Sheet.SchDoc, Top_Sheet.SchDoc]
2024-05-14 #2 33R resistance added in Series at output
    [Audio-Switch-v1.0.PrjPcb, I2S-to-SPDIF-Sheet.SchDoc]
2024-05-15 #2 Capacitors and resistors packages changed as required
    [Controller-Sheet.SchDoc, I2S-to-SPDIF-Sheet.SchDoc, Power-Sheet.SchDoc, SPDIF-to-I2S-Sheet.SchDoc]
2024-05-15 #3 Routing in Progress
    [Audio-Switch-v1.0.PcbDoc, Audio-Switch-v1.0.PrjPcb]
2024-05-17 #3 #2 Switch connections changed according to routing requirement
    [Controller-Sheet.SchDoc]
2024-05-17 #3 Routing Completed
    [Audio-Switch-v1.0.PcbDoc, Audio-Switch-v1.0.PrjPcb, I2S-to-SPDIF-Sheet.SchDoc]
2024-05-20 #3 PCB Design Completed and fresh deliverables generated
    [Audio-Switch-v1.0.DWG, Audio-Switch-v1.0.DXF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]
2024-06-21 pdf generated v2.0
    [Audio-Switch-v1.0.DWG, Audio-Switch-v1.0.DXF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]
